DonkeyDrift/Hardware/DonkeyDrift-MUS4.kicad_pcb

## KiCad design DonkeyDrift-MUS4.kicad_pcb (2026-11-12)

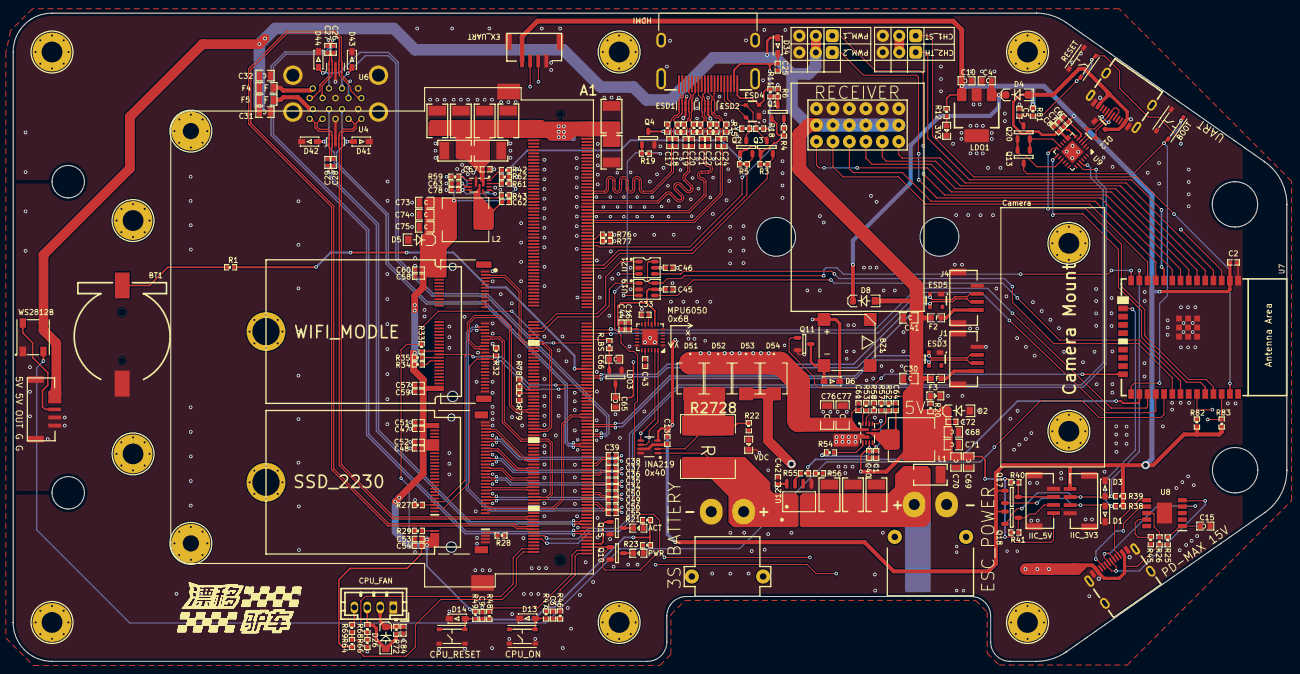
[picture p1: board DonkeyDrift-MUS4.kicad_pcb from above]

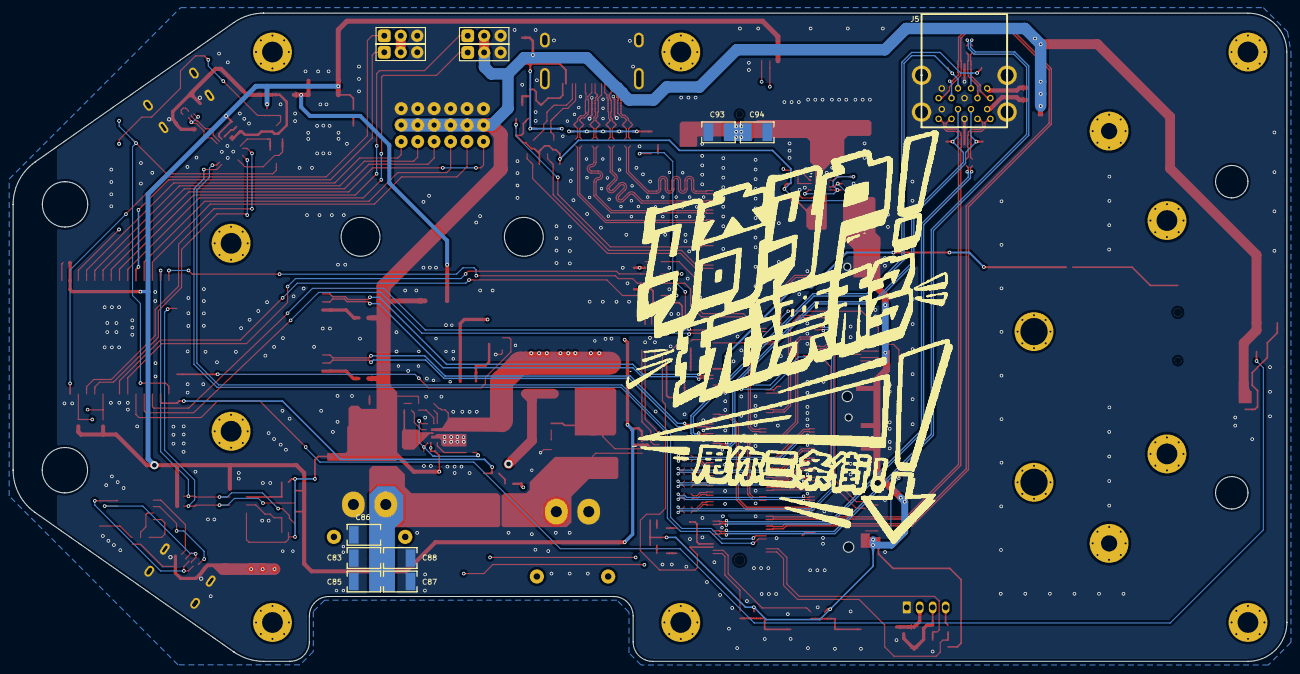
[picture p2: board DonkeyDrift-MUS4.kicad_pcb from below]

Board: 4 copper layers, 196.5 x 100.0 mm, 261 parts (12 on the bottom side), 198 nets.

Parts:
0x40: INA219AxD; SOT-23-8
0x68: MPU-6050; QFN-24-4X4-PAD
3S BATTERY: Conn_01x02_Pin; XT30PW-M
3V3, 5V: LED_Y; LED-0603-Y
5V 5V OUT G G: Conn_01x05_Socket; GH1.25-立-5P
A1: ASAA826-E8SB0-7H; LattePanda_Module_H8.0mm_Horizontal
ACT: LED_R; LED-0603-R
BOOT: SW_Push; SWITCH-3*4*2.5
BT1: XDCR-1220-006; Battery_Holder_CR1220_S8411-45R
BZ1: Buzzer; BEEP-MLT-8530
C1: 25V/1uf; C-0402
C2, C7, C8, C16, C17, C18, C19, C20, C21, C22, C23, C24, C25, C26, C27, C28, C29, C33, C40, C45, C46, C47, C48, C54, C59, C60, C61, C63, C67, C72, C84: 50V/100nf; C-0402
C3, C5, C6, C9, C44, C51, C52, C53, C57, C58, C78: 10V/1uf; C-0402
C4, C10: 10V/10uf; C-0603
C13, C42: 50V/100pf; C-0402
C15, C65, C66: 25V/1uf; C-0603
C30, C31, C32, C41, C68, C69, C70, C71, C73, C74, C75: 16V/22uf; C-0805
C34, C35, C36, C37, C38, C39, C49, C50, C55, C56, C62, C64: 50V/220nf; C-0402
C43: 50V/2.2nf; C-0402
C76, C77: 25V/22uf; C-1206
C80, C81, C82, C83, C85, C86, C87, C88, C89, C90, C91, C92, C93, C94, C95, C96, C97, C98, C99: 25V/47uf; C-1210
CH1_ST, CH2_TH: Conn_01x03_Socket; J-2.54-1X3
CPU_FAN: Fan_4pin; JST_PH_B4B-PH-K_1x04_P2.00mm_Vertical
CPU_ON: SW_Push; SWITCH-3*4*2.5
CPU_RESET: SW_Push; SWITCH-3*4*2.5
Camera: 摄像头; Camera Mount
D1, D3, D13, D14: ESD5V0B03; SOD-323
D2, D5: SMFJ5.0CA; SOD-123
D4, D8, D26: 1N5819WS; SOD-123
D6: 1N4148WS; SOD-323
D12: SP0503BAHT; SOT-143
D34: 1N5819WS; SOD-323
D41, D42, D43, D44: ESD-5V0B03; SOD-323
D51, D52, D53, D54: SL54B; c167b71becf44403bc24886c573a5209
DCDC1, DCDC2: MP8756GD; QFN-12-MP8756
ESC_POWER: 电调供电; XT30PW-F
ESD1, ESD2: TPAZ1023-04F; ESD-USON-10_0P5_2P5X1X0P55MM
ESD3, ESD4, ESD5: SP0503BAHT; SOT-143
EX_UART: Conn_01x04_Socket; GH1.25-立-4P
F2, F3: 6V/500mA; FUSE-0603
F4, F5: 6V/1A; FUSE-0805
FID1, FID2, FID3, FID4, FID5, FID6, FID7, FID8: Fiducial; 铜柱
HDMI: HDMI_A
IIC_3V3, IIC_5V: Conn_01x04_Socket; GH1.25-立-4P
J1, J4: Conn_01x04_Socket; GH1.25-立-4P
J5: USB3_A; USB3_A_HanElctricity
L1, L2: 3.3uH/5.2A; L-0630
LDO1: SGM2225-3.3XKC3G/TR; SOT-223-3_TabPin2
LDO3: LDO-XC6206P332MR; SOT-23-3
LOGO: LOGO-2
LOGO3: LOGO-3
PD-MAX 15V: USB_C_Receptacle_USB2.0_16P; USB-C-16P
PWM_1, PWM_2: Conn_01x03_Socket; J-2.54-1X3
PWR: LED_G; LED-0603-G
Q1, Q2, Q3, Q4, Q10, Q11, Q15, Q17, Q18: AO3400A; SOT-23-3
Q13, Q20: 2N7002; SOT-23-3
R1: 750; R-0402
R3, R5, R12, R15, R18, R19, R21, R23: 2.2K; R-0402
R4, R42, R53: 1M; R-0402
R6, R68: 21.5K; R-0402
R7, R8, R9, R10, R13, R14, R16, R17, R56: 470R; R-0402
R11: 1K; R-0402
R20, R72: 4.7K; R-0402
R22: 18K; R-0402
R25: 1K 1%; R-0402
R26: 10K 1%; R-0402
R27, R29, R32, R33: 0R; R-0402
R28, R47, R49, R64, R66: NC; R-0402
R34, R35, R78, R79, R81: 10K; R-0402
R38, R39, R82, R83: 3.3K; R-0402
R40, R41: 5.1K; R-0402
R43, R52: 3.3R; R-0402
R45: 56K 1%; R-0402
R46, R48, R69: 100R; R-0402
R54, R59, R76, R77: 100K; R-0402
R55: 680R; R-0402
R57: 41.2K; R-0402
R58: 5.6K; R-0402
R61: 43K; R-0402
R62: 9.53K; R-0402
R2728: 0.01R; R-2728
RECEIVER: RC_MODULE; RC_INTERFACE
RESET: SW_Push; SWITCH-3*4*2.5
R_BS: 10K; R-0402
SSD_2230: APCI0079-P002A; PCIE_M.2_CONNECTORS_P=0.5MM_H=4.2MM_KEYM
U4, U6: ULC0524P; ESD-USON-10_0P5_2P5X1X0P55MM
U7: ESP32-WROOM-32E-N4; ESP32-WROOM-32E
U8: CH224K; SOP100P600X180-11N
U9: CH342F; QFN-24-4X4-PAD
U12: CC6900SO; SOP-8
U19, U21: TS5A3159ADBVR; SOT-23-6
UART: USB_C_Receptacle_USB2.0_16P; USB-C-16P
VDC: LED_R; LED-0603-R
WIFI_MODLE: APCI0085-P005A; PCIE_M.2_CONNECTORS_P=0.5MM_H=4.2MM_KEYE
WS2812B: LED-WS2812B; LED-5050-4P

Connections:
5V_HDMI_VCC: C25.2, D34.1, HDMI.18, R15.2, R18.2
+3V3: 0x40.4, 0x68.8, 0x68.13, BZ1.1, C2.1, C6.2, C10.2, C13.2, C16.2, C44.2, C45.2, C46.2, D6.1, EX_UART.1, IIC_3V3.1, LDO1.3, Q17.1, Q18.1, R12.2, R38.2, R39.2, R81.2, R82.1, R83.2, U7.2, U9.5, U19.5, U21.5
+3V3C: C47.1, C48.2, C51.1, C52.1, C53.1, C54.2, C57.1, C58.1, C59.1, C60.1, R34.2, R35.2, SSD_2230.2, SSD_2230.4, SSD_2230.12, SSD_2230.14, SSD_2230.16, SSD_2230.18, SSD_2230.70, SSD_2230.72, SSD_2230.74, WIFI_MODLE.2, WIFI_MODLE.4, WIFI_MODLE.72, WIFI_MODLE.74
+5V: 5V 5V OUT G G.4, 5V 5V OUT G G.5, C30.2, C31.2, C32.2, C40.2, C41.2, C42.2, C68.2, C69.2, C70.2, C71.2, C72.2, C84.2, CPU_FAN.2, D2.1, D8.2, D26.1, D34.2, DCDC1.5, F2.1, F3.1, F4.1, F5.1, IIC_5V.1, L1.2, PWM_1.2, PWM_2.2, R20.2, R40.2, R41.2, R57.2, R72.2, RECEIVER.7, U12.8, WS2812B.1
+5V_USB: C8.2, D4.2, D12.4, U9.7, U9.8, UART.A4
+BATT: A1.115, R1.1
BEC_5V: CH1_ST.2, CH2_TH.2
BOOT: BOOT.1, Q13.3, U7.25
BZ: Q11.1, U7.24
CHIP_PU: C5.2, Q20.3, R81.1, RESET.2, U7.3
CON_PCIE_TX_0_N: C56.2, WIFI_MODLE.37
CON_PCIE_TX_0_P: C55.2, WIFI_MODLE.35
CON_PCIE_TX_1_N: C50.2, SSD_2230.47
CON_PCIE_TX_1_P: C49.2, SSD_2230.49
CON_PCIE_TX_2_N: C35.2, SSD_2230.35
CON_PCIE_TX_2_P: C34.2, SSD_2230.37
CON_PCIE_TX_3_N: C37.2, SSD_2230.23
CON_PCIE_TX_3_P: C36.2, SSD_2230.25
CON_PCIE_TX_4_N: C39.2, SSD_2230.11
CON_PCIE_TX_4_P: C38.2, SSD_2230.13
CPU_RX0: A1.12, U9.21
CPU_RX2: A1.140, U21.1
CPU_TX0: A1.10, U9.20
CPU_TX2: A1.138, U19.1
DDC_SCL: ESD4.4, HDMI.15, Q2.3, R15.1
DDC_SDA: ESD4.3, HDMI.16, Q3.3, R18.1
DDI_B_TX0_N: A1.215, C18.1
DDI_B_TX0_P: A1.217, C17.1
DDI_B_TX1_N: A1.209, C20.1
DDI_B_TX1_P: A1.211, C19.1
DDI_B_TX2_N: A1.203, C22.1
DDI_B_TX2_P: A1.205, C21.1
DDI_B_TX3_N: A1.197, C24.1
DDI_B_TX3_P: A1.199, C23.1
DTR: Q13.2, Q20.1, U9.15
EX_RX: EX_UART.3, U19.3
EX_TX: EX_UART.2, U21.3
FAN_1_PWM: A1.2, R64.1, R69.1
FAN_1_TAC: A1.4, R66.2, R68.2
GND: 0x40.3, 0x40.7, 0x40.8, 0x68.1, 0x68.9, 0x68.11, 0x68.18, 0x68.25, 3S BATTERY.2, 3V3.1, 5V.1, 5V 5V OUT G G.1, 5V 5V OUT G G.2, 5V 5V OUT G G.MP, A1.11, A1.14, A1.17, A1.20, A1.23, A1.26, A1.29, A1.32, A1.35, A1.38, A1.41, A1.44, A1.47, A1.50, A1.53, A1.56, A1.59, A1.62, A1.65, A1.68, A1.71, A1.74, A1.77, A1.80, A1.83, A1.86, A1.89, A1.92, A1.95, A1.98, A1.101, A1.107, A1.110, A1.113, A1.116, A1.135, A1.136, A1.151, A1.158, A1.167, A1.170, A1.181, A1.182, A1.188, A1.189, A1.194, A1.195, A1.200, A1.201, A1.206, A1.207, A1.212, A1.213, A1.218, A1.219, A1.224, A1.225, A1.230, A1.231, A1.236, A1.237, A1.242, A1.243, A1.248, A1.249, A1.MP, BOOT.2, BT1.2, C1.1, C2.2, C3.1, C4.1, C5.1, C6.1, C7.1, C8.1, C9.1, C10.1, C13.1, C15.1, C16.1, C25.1, C30.1, C31.1, C32.1, C33.1, C40.1, C41.1, C42.1, C43.2, C44.1, C45.1, C46.1, C47.2, C48.1, C51.2, C52.2, C53.2, C54.1, C57.2, C58.2, C59.2, C60.2, C61.1, C63.1, C65.1, C66.2, C67.1, C68.1, C69.1, C70.1, C71.1, C72.1, C73.1, C74.1, C75.1, C76.1, C77.1, C78.1, C80.1, C81.1, C82.1, C83.1, C84.1, C85.1, C86.2, C87.2, C88.2, C89.2, C90.2, C91.2, C92.2, C93.2, C94.2, C95.1, C96.1, C97.1, C98.1, C99.1, CH1_ST.3, CH2_TH.3, CPU_FAN.1, CPU_ON.2, CPU_RESET.2, D1.1, D2.2, D3.1, D5.2, D12.1, D13.1, D14.1, D41.1, D42.1, D43.1, D44.1, DCDC1.2, DCDC1.10, DCDC2.2, DCDC2.10, ESC_POWER.2, ESD1.3, ESD1.8, ESD2.3, ESD2.8, ESD3.1, ESD4.1, ESD5.1, EX_UART.4, EX_UART.MP, HDMI.2, HDMI.5, HDMI.8, HDMI.11, HDMI.17, HDMI.SH, IIC_3V3.4, IIC_3V3.MP, IIC_5V.4, IIC_5V.MP, J1.4, J1.MP, J4.4, J4.MP, J5.4, J5.7, J5.13, J5.16, J5.19, LDO1.2, LDO1.4, LDO3.1, PD-MAX 15V.A1, PD-MAX 15V.S1, PWM_1.3, PWM_2.3, Q4.2, Q10.2, Q11.2, Q15.2, R6.1, R27.2, R28.2, R32.2, R45.1, R56.1, R58.1, R62.1, R66.1, R76.1, R77.1, R78.1, R79.1, RECEIVER.8, RESET.1, SSD_2230.1, SSD_2230.3, SSD_2230.9, SSD_2230.15, SSD_2230.21, SSD_2230.27, SSD_2230.33, SSD_2230.38, SSD_2230.39, SSD_2230.45, SSD_2230.51, SSD_2230.57, SSD_2230.71, SSD_2230.73, SSD_2230.75, U4.3, U4.8, U6.3, U6.8, U7.1, U7.39, U8.11, U9.2, U9.25, U12.5, U19.2, U21.2, UART.A1, UART.S1, VDC.1, WIFI_MODLE.1, WIFI_MODLE.7, WIFI_MODLE.18, WIFI_MODLE.33, WIFI_MODLE.39, WIFI_MODLE.45, WIFI_MODLE.51, WIFI_MODLE.57, WIFI_MODLE.63, WIFI_MODLE.69, WIFI_MODLE.75, WS2812B.3
HPD: ESD4.2, HDMI.19, R11.2
ID_MOTO: R55.2, R56.2, U7.26
J1_USB_2_P5_N: A1.109, ESD5.3, J4.2
J1_USB_2_P5_P: A1.111, ESD5.2, J4.3
J4_USB_2_P3_N: A1.79, ESD3.3, J1.2
J4_USB_2_P3_P: A1.81, ESD3.2, J1.3
J5_USB3_SSRX_N: A1.18, J5.5, U6.4, U6.7
J5_USB3_SSRX_P: A1.16, J5.6, U6.5, U6.6
J5_USB3_SSTX_N: C26.2, J5.8, U6.2, U6.9
J5_USB3_SSTX_P: C27.2, J5.9, U6.1, U6.10
J5_USB_2_P2_N: A1.73, D44.2, J5.2
J5_USB_2_P2_P: A1.75, D43.2, J5.3
J6_USB4_SSRX_N: A1.24, J5.14, U4.5, U4.6
J6_USB4_SSRX_P: A1.22, J5.15, U4.4, U4.7
J6_USB4_SSTX_N: C28.2, J5.17, U4.2, U4.9
J6_USB4_SSTX_P: C29.2, J5.18, U4.1, U4.10
J6_USB_2_P1_N: A1.67, D42.2, J5.11
J6_USB_2_P1_P: A1.69, D41.2, J5.12
MCU_RX0: U7.34, U9.13
MCU_RX2: U7.31, U19.4
MCU_TX0: U7.35, U9.12
MCU_TX2: U7.30, U21.4
Net3V3_2: 3V3.2, R12.1
Net5V 5V OUT G G_3: 5V 5V OUT G G.3, WS2812B.2
Net5V_2: 5V.2, R20.1
NetA1_1: A1.1, R46.1
NetA1_3: A1.3, R48.1
NetA1_5: A1.5, Q10.1
NetA1_7: A1.7, Q15.1
NetA1_100: A1.100, R79.2
NetA1_102: A1.102, R78.2
NetA1_131: A1.131, R29.2, R33.2
NetA1_133: A1.133, R_BS.1
NetA1_137: A1.137, U7.28
NetA1_139: A1.139, U7.27
NetA1_169: A1.169, Q3.2, R3.1
NetA1_171: A1.171, Q2.2, R5.1
NetA1_183: A1.183, Q1.2, R4.1
NetA1_185: A1.185, R77.2
NetA1_187: A1.187, R76.2
NetBT1_1: BT1.1, R1.2
NetBZ1_2: BZ1.2, D6.2, Q11.3
NetC1_2: C1.2, DCDC1.6, DCDC1.9, R54.2
NetC3_2: C3.2, CPU_ON.1, D13.2, R46.2, R47.1
NetC4_2: C4.2, D4.1, D8.1, LDO1.1
NetC7_2: C7.2, U9.6
NetC9_2: C9.2, CPU_RESET.1, D14.2, R48.2, R49.1
NetC15_2: C15.2, R25.2, U8.1
NetC33_2: 0x68.10, C33.2
NetC43_1: 0x68.20, C43.1
NetC62_1: C62.1, DCDC2.7, L2.1
NetC62_2: C62.2, R43.2
NetC64_1: C64.1, DCDC1.7, L1.1
NetC64_2: C64.2, R52.2
NetC66_1: C66.1, LDO3.2, R_BS.2
NetC78_2: C78.2, DCDC2.6, DCDC2.9, R59.2
NetCH1_ST_1: CH1_ST.1, U7.37
NetCH2_TH_1: CH2_TH.1, U7.10
NetCPU_FAN_3: CPU_FAN.3, D26.2, R68.1, R72.1
NetCPU_FAN_4: CPU_FAN.4, R69.2
NetD12_2: D12.2, U9.4, UART.A7, UART.B7
NetD12_3: D12.3, U9.3, UART.A6, UART.B6
NetD53_1: D53.2, D54.2, PD-MAX 15V.A4, R25.1, R26.2
NetDCDC1_3: DCDC1.3, R54.1
NetDCDC1_8: DCDC1.8, R52.1
NetDCDC1_11: DCDC1.11, R57.1, R58.2
NetDCDC1_12: DCDC1.12, R53.1
NetDCDC2_3: DCDC2.3, R59.1
NetDCDC2_8: DCDC2.8, R43.1
NetDCDC2_11: DCDC2.11, R61.1, R62.2
NetDCDC2_12: DCDC2.12, R42.1
NetF2_2: F2.2, J4.1
NetF3_2: F3.2, J1.1
NetF4_2: F4.2, J5.1
NetF5_2: F5.2, J5.10
NetIIC_5V_2: IIC_5V.2, Q18.3, R41.1
NetIIC_5V_3: IIC_5V.3, Q17.3, R40.1
NetPD-MAX 15V_A5: PD-MAX 15V.A5, U8.7
NetPD-MAX 15V_A6: PD-MAX 15V.A6, PD-MAX 15V.B6, U8.4
NetPD-MAX 15V_A7: PD-MAX 15V.A7, PD-MAX 15V.B7, U8.5
NetPD-MAX 15V_B5: PD-MAX 15V.B5, U8.6
NetPWM_1_1: PWM_1.1, U7.8
NetPWM_2_1: PWM_2.1, U7.9
NetPWR_1: PWR.1, Q10.3
NetPWR_2: PWR.2, R23.1
NetQ1_3: Q1.3, R6.2, R11.1
NetQ4_1: Q4.1, R19.1
NetQ4_3: Q4.3, R7.1, R8.1, R9.1, R10.1, R13.1, R14.1, R16.1, R17.1
NetQ15_3: ACT.1, Q15.3
NetR21_1: ACT.2, R21.1
NetR22_1: R22.1, VDC.2
NetR26_1: R26.1, U8.8
NetR28_1: R28.1, SSD_2230.69
NetR29_1: R29.1, SSD_2230.68
NetR33_1: R33.1, WIFI_MODLE.50
NetR34_1: R34.1, WIFI_MODLE.56
NetR35_1: R35.1, WIFI_MODLE.54
NetR45_2: R45.2, U8.9
NetR55_1: R55.1, U12.7
PCIE_RX_0_N: A1.36, WIFI_MODLE.43
PCIE_RX_0_P: A1.34, WIFI_MODLE.41
PCIE_RX_1_N: A1.42, SSD_2230.41
PCIE_RX_1_P: A1.40, SSD_2230.43
PCIE_RX_2_N: A1.48, SSD_2230.29
PCIE_RX_2_P: A1.46, SSD_2230.31
PCIE_RX_3_N: A1.54, SSD_2230.17
PCIE_RX_3_P: A1.52, SSD_2230.19
PCIE_RX_4_N: A1.60, SSD_2230.5
PCIE_RX_4_P: A1.58, SSD_2230.7
PCIE_TX_0_N: A1.33, C56.1
PCIE_TX_0_P: A1.31, C55.1
PCIE_TX_1_N: A1.39, C50.1
PCIE_TX_1_P: A1.37, C49.1
PCIE_TX_2_N: A1.45, C35.1
PCIE_TX_2_P: A1.43, C34.1
PCIE_TX_3_N: A1.51, C37.1
PCIE_TX_3_P: A1.49, C36.1
PCIE_TX_4_N: A1.57, C39.1
PCIE_TX_4_P: A1.55, C38.1
PWM_IN1: RECEIVER.1, U7.4
PWM_IN2: RECEIVER.2, U7.5
PWM_IN3: RECEIVER.3, U7.6
PWM_IN4: RECEIVER.4, U7.11
PWM_IN5: RECEIVER.5, U7.12
PWM_IN6: RECEIVER.6, U7.7
REFCLKE_N: A1.90, WIFI_MODLE.49
REFCLKE_P: A1.88, WIFI_MODLE.47
REFCLKM_N: A1.87, SSD_2230.53
REFCLKM_P: A1.85, SSD_2230.55
RTS: Q13.1, Q20.2, U9.11
SCL0: 0x40.5, 0x68.23, R83.1, U7.36
SCL_3: D3.2, IIC_3V3.2, Q18.2, R39.1, U7.13
SDA0: 0x40.6, 0x68.24, R82.2, U7.33
SDA_3: D1.2, IIC_3V3.3, Q17.2, R38.1, U7.16
TMDS_CK_N: C24.2, ESD2.1, ESD2.10, HDMI.12, R7.2
TMDS_CK_P: C23.2, ESD2.2, ESD2.9, HDMI.10, R8.2
TMDS_D0_N: C22.2, ESD2.4, ESD2.7, HDMI.9, R9.2
TMDS_D0_P: C21.2, ESD2.5, ESD2.6, HDMI.7, R10.2
TMDS_D1_N: C20.2, ESD1.1, ESD1.10, HDMI.6, R13.2
TMDS_D1_P: C19.2, ESD1.2, ESD1.9, HDMI.4, R14.2
TMDS_D2_N: C18.2, ESD1.4, ESD1.7, HDMI.3, R16.2
TMDS_D2_P: C17.2, ESD1.5, ESD1.6, HDMI.1, R17.2
UART_SEL: U7.14, U19.6, U21.6
USB3_SSTX_N: A1.15, C26.1
USB3_SSTX_P: A1.13, C27.1
USB4_SSTX_N: A1.21, C28.1
USB4_SSTX_P: A1.19, C29.1
USB_2_P7_N: A1.78, WIFI_MODLE.5
USB_2_P7_P: A1.76, WIFI_MODLE.3
VCPU: A1.250, A1.251, A1.252, A1.253, A1.254, A1.255, A1.256, A1.257, A1.258, A1.259, A1.260, C61.2, C65.2, C67.2, C76.2, C77.2, C90.1, C91.1, C92.1, C93.1, C94.1, C95.2, C96.2, C97.2, C98.2, C99.2, D51.1, D52.1, D53.1, D54.1, DCDC1.1, DCDC2.1, LDO3.3, R42.2, R53.2
VDC: 0x40.2, D51.2, D52.2, R22.2, R2728.1
VIN: 0x40.1, 3S BATTERY.1, R2728.2, U12.1, U12.2
VMOTO: C80.2, C81.2, C82.2, C83.2, C85.2, C86.1, C87.1, C88.1, C89.1, ESC_POWER.1, U12.3, U12.4
WS2812: U7.29, WS2812B.4
~{CLKREQE}: R32.1, WIFI_MODLE.53
~{CLKREQM}: R27.1, SSD_2230.52
~{PLT_RST}: A1.105, SSD_2230.50, WIFI_MODLE.52
~{WAKE}: A1.103, SSD_2230.54, WIFI_MODLE.55
